AshanXJay/2-dof-arm/docs/section.png

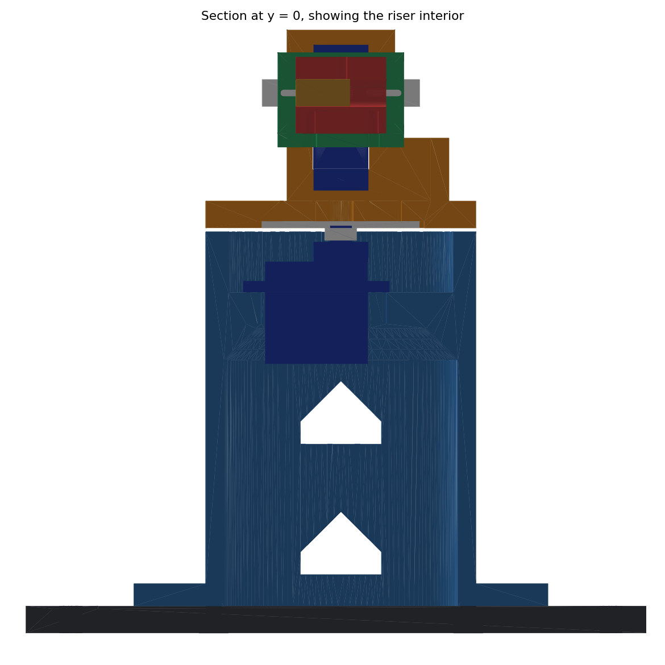
docs/section.png
