AshanXJay/2-dof-arm/docs/side_front.png

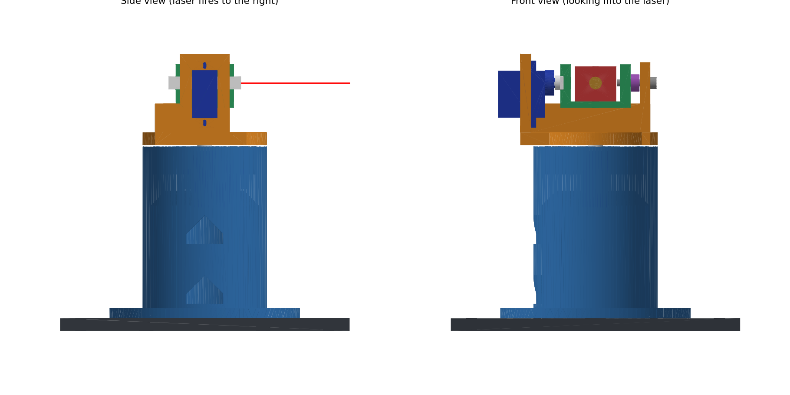
docs/side_front.png
