AshanXJay/2-dof-arm/docs/printed_parts.png

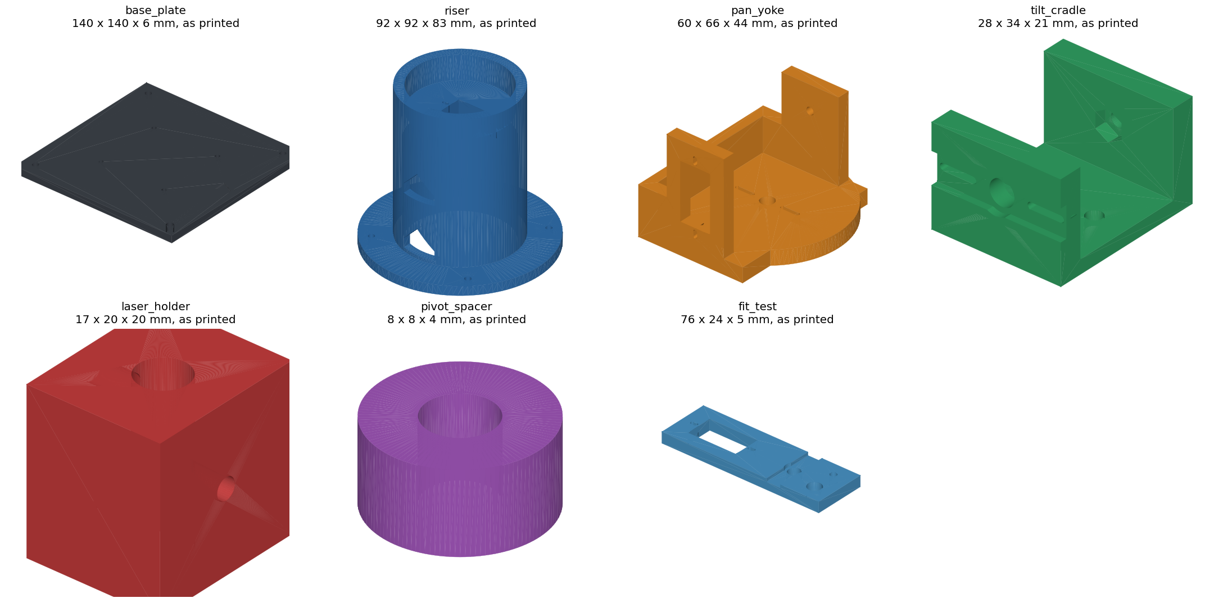
docs/printed_parts.png
