AshanXJay/2-dof-arm/step/assembly_home_pose.step

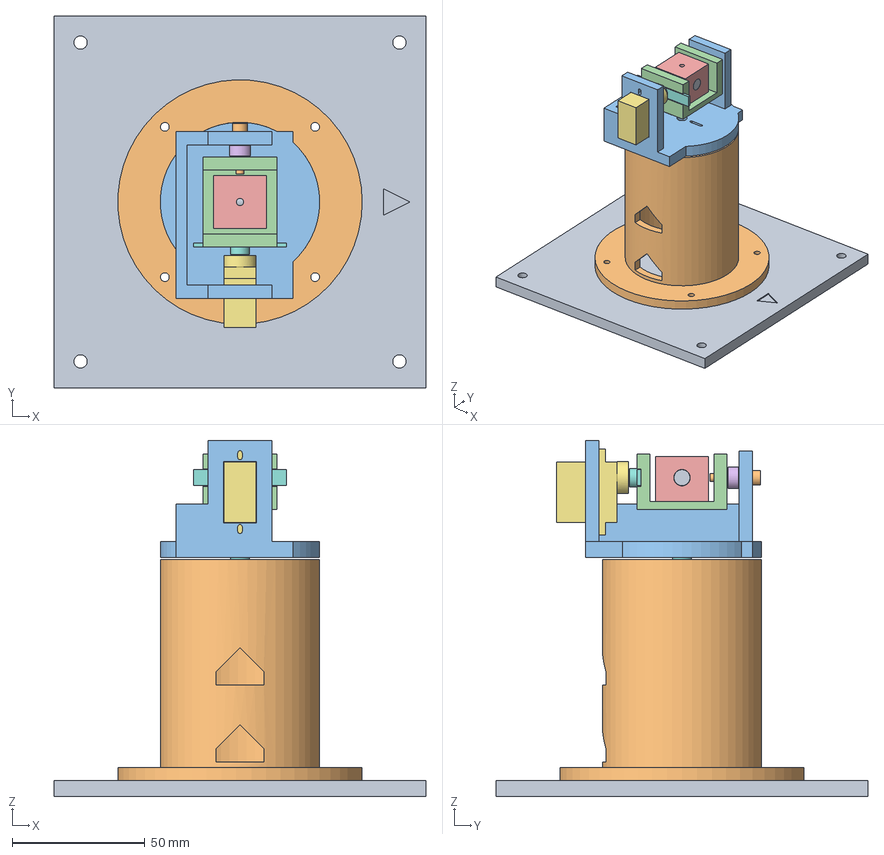
[picture p6: CAD file, 2026-11-04]
step/assembly_home_pose.step
140.0 x 140.0 x 134.0 mm
