AshanXJay/2-dof-arm/step/4_tilt_cradle.step

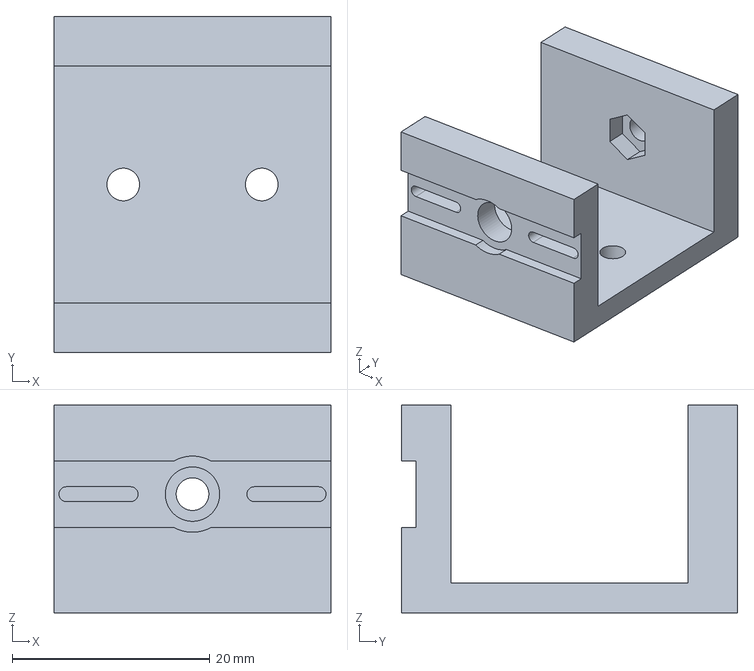
[picture p7: CAD file, 2026-11-04]
step/4_tilt_cradle.step
28.0 x 34.0 x 21.0 mm
