AshanXJay/2-dof-arm/step/5_laser_holder.step

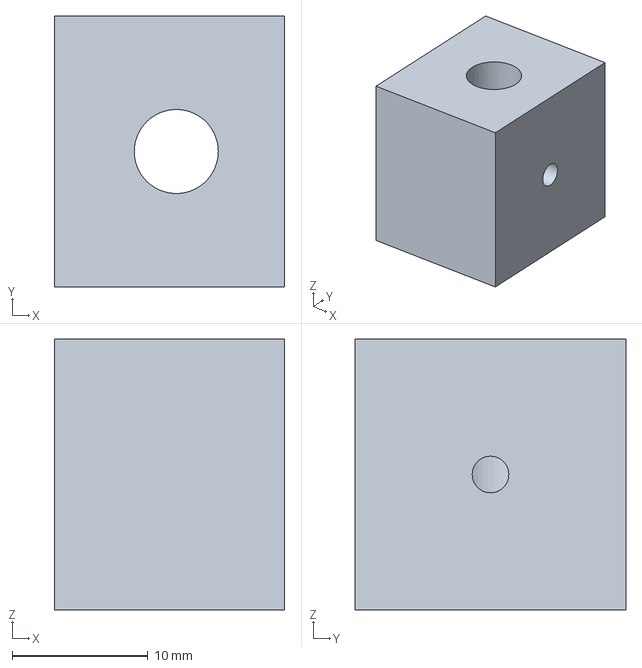
[picture p8: CAD file, 2026-11-04]
step/5_laser_holder.step
17.0 x 20.0 x 20.0 mm
