AshanXJay/2-dof-arm/step/2_riser.step

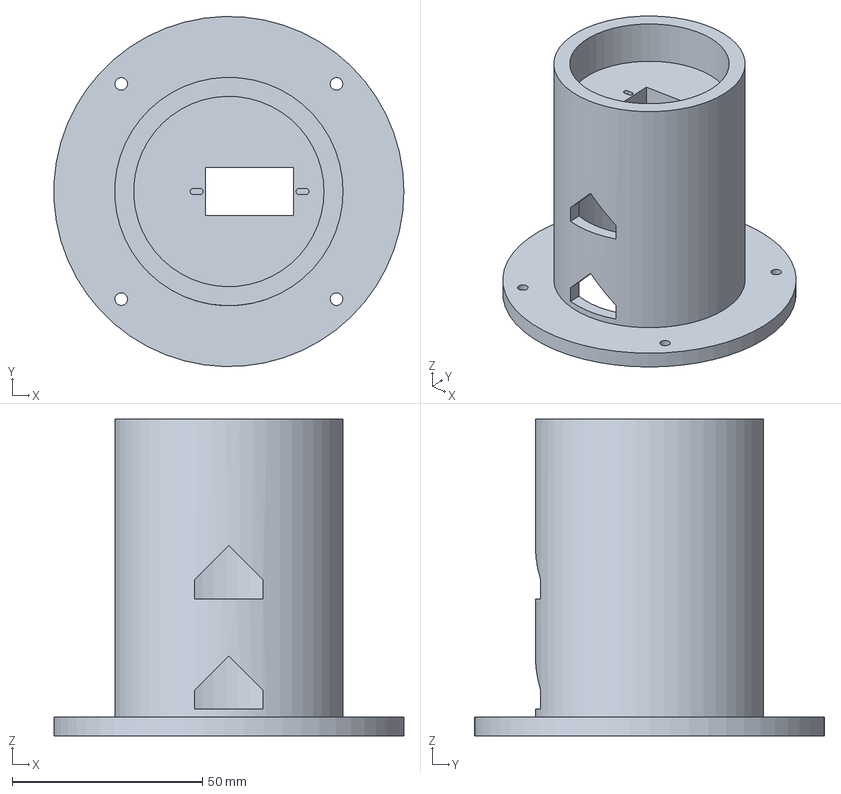
[picture p9: CAD file, 2026-11-04]
step/2_riser.step
91.9 x 92.0 x 83.2 mm
