AshanXJay/2-dof-arm/step/6_pivot_spacer.step

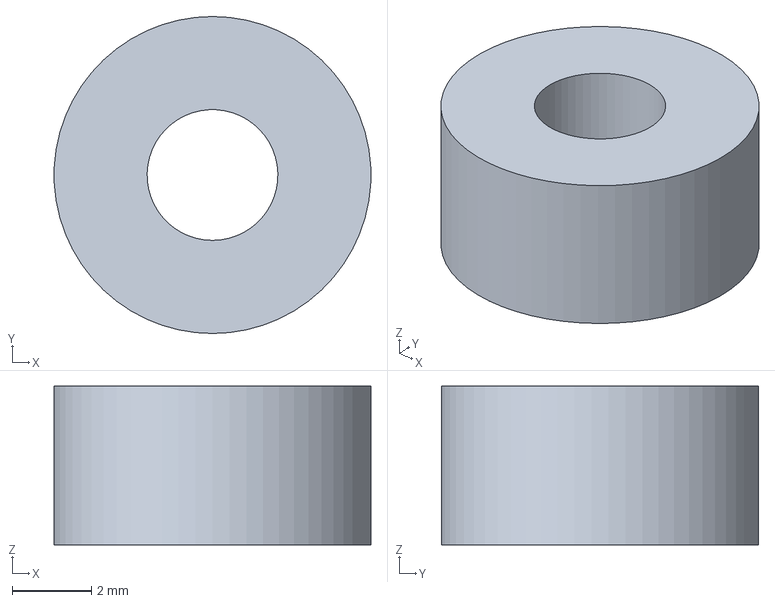
[picture p10: CAD file, 2026-11-04]
step/6_pivot_spacer.step
7.99 x 8.00 x 4.00 mm
