AshanXJay/2-dof-arm/step/1_base_plate.step

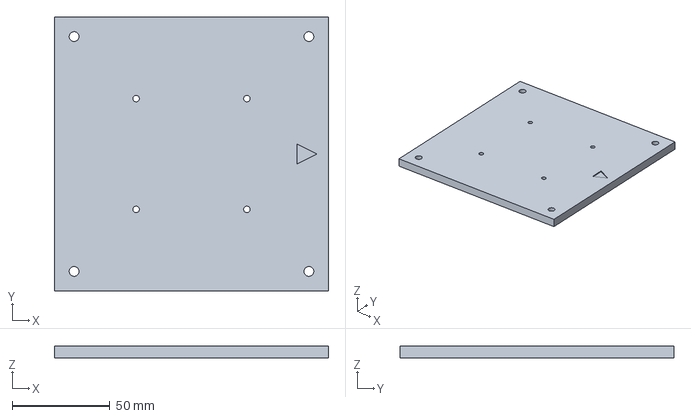
[picture p11: CAD file, 2026-11-04]
step/1_base_plate.step
140.0 x 140.0 x 6.00 mm
