AshanXJay/2-dof-arm/step/0_fit_test_print_first.step

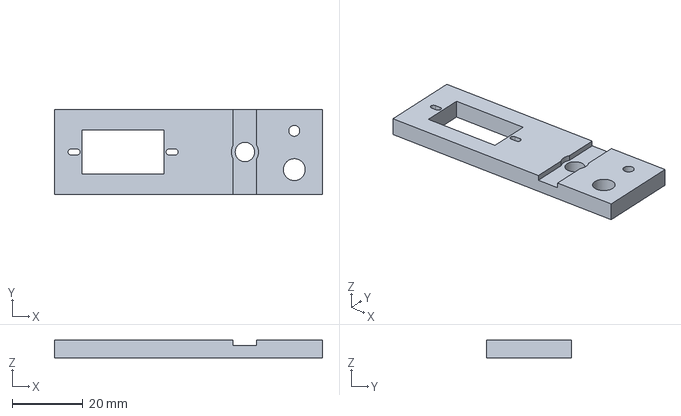
[picture p12: CAD file, 2026-11-04]
step/0_fit_test_print_first.step
76.0 x 24.0 x 5.00 mm
