AshanXJay/2-dof-arm/step/3_pan_yoke.step

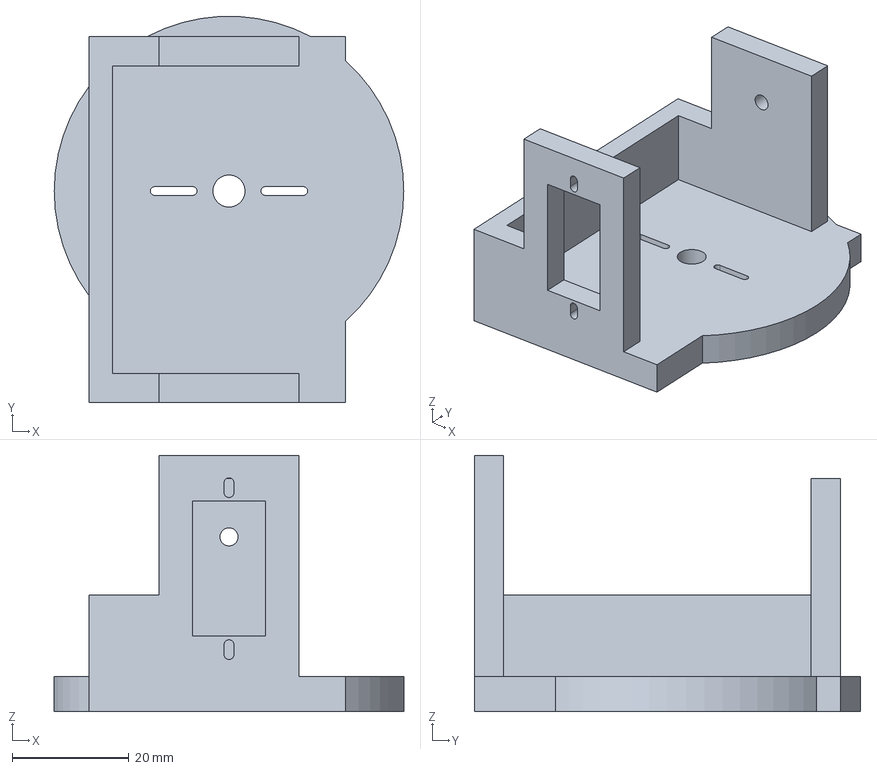
[picture p13: CAD file, 2026-11-04]
step/3_pan_yoke.step
60.0 x 66.3 x 44.0 mm
