AshanXJay/2-dof-arm/(list of files, cad)

Other CAD files:
cad/arm_2dof.FCStd
stl/0_fit_test_print_first.stl
stl/1_base_plate.stl
stl/2_riser.stl
stl/3_pan_yoke.stl
stl/4_tilt_cradle.stl
stl/5_laser_holder.stl
stl/6_pivot_spacer.stl
